artofimagination/pumped-storage/docs/FluidMechanics.ods

Sheet: FluidMechanics
Fluid Mechanics calculator
Measurements | Aperture diameter (m) | Emptying time (s)
 | 0.0015 | 1650
 | 0.003 | 340
 | 0.005 | 65
Calculate emptying time
https://www.engineeringtoolbox.com/flow-liquid-water-tank-d_1753.html
Constants: | Height of tank fluid (m) | Aperture diameter (m) | Area of aperture (m2) | Outlet velocity (m/s)
Gravitational Acceleration (m/s2) | 2.3 | 0.006 | 0.00002827 | 6.51606118755802
9.81 |  |  | Discharge Coeff | Volume flow (l/min)
Velocity Coefficient (water) |  |  | 0.6014 | 6.8536271736618
0.97 |  |  | Perimeter (m)
Tank fluid volume (liters) |  |  | 0.018849555921539
1.3 | Result (10 segment)
Pi | Segment | Height (m) | Volume Flow (l/min) | Volume in segment(m3) | Time to drain (s) | Hydrostatic pressure (MPa) | Total flow rate (with n tanks)(l/min) | Head loss (m) | Total head (m) | Volume (m3) | Outlet velocity (m/s) | Pressure loss (Mpa) | Resistance
3.14159265358979 | 1 | 2.185 | 6.68008945776759 | 0.00013 | 1.16764903364134 | 0.122752006427521 | 26.7203578310704 | 0.034274694591636 | 4.1490580583204 | 0.001235 | 6.35107083333197 | 0.000007844
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
