artofimagination/pumped-storage/docs/top_tank.jpg

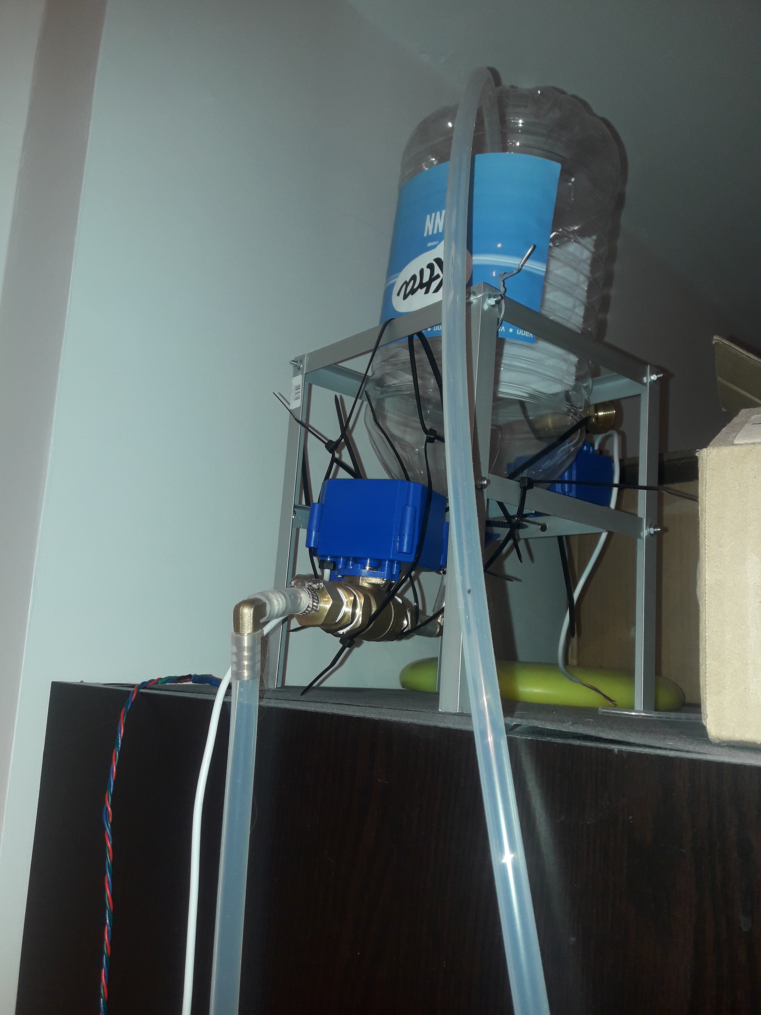
[picture p1: docs/top_tank.jpg]
docs/top_tank.jpg
